Cosmic7373/ECE411/Documents/DesignReview.pdf

Team 13 Design Review
Done by Team 4
1) Include a short description of what your board does (anywhere but can be in the space above the TITLE, and include document number, revision number.
2) Approve your ERC warning
3) Your dimension layer (to draw the outline) is not straight (if you zoom in). Not sure if this would be the problem though.
4) I think your polygon should be overlapping with your dimension layer.
5) After you type DRC and load the oshpark 2 layer .dru file, click on the Masks tab and change the Limit to 0.4mm. This is because your GND vias have dimension of 0.35 mm so the Mask limit can be set to any value larger than that. This is to make your GND vias filled with solder mask.
6) Have your team name, project name, etc. on the tPlace layer. (type layer and select tPlace)
