Cosmic7373/ECE411/Documents/BOM.xlsx

Part | Value | MPN | Device | Package | Quantity Per Board | Description | DESC | MFR
SW2 | !RESET | RS-187R05A2-DS MT RT | SWITCH-MOMENTARY-2SMD | TACTILE_SWITCH_SMD | 1 | Various NO switches- pushbuttons, reed, etc | SWITCH TACTILE SPST-NO 0.05A 12V | C&K
C20 | .1u |  | C2,5-3 | C2.5-3 | 1 | CAPACITOR
C15 | .33u |  | C2,5-3 | C2.5-3 | 1 | CAPACITOR
C2, C3, C4, C9, C10, C11, C18 | 100n | CL21B104KBCNNNC | C-EUC0805K | C0805K | 7 | CAPACITOR, European symbol | CAP CER 0.1UF 50V X7R 0805 | Samsung
R2, R3, R6, R13, R14, R15, R16, R17, R18, R19, R20 | 10k | RC0805FR-0710KL | R-US_R0805 | R0805 | 11 | RESISTOR, American symbol | RES SMD 10K OHM 1% 1/8W 0805 | Yageo
X2 | 16 MHz | ECS-160-18-5PX-TR | CRYSTALSMD-HC49UP | HC49UP | 1 | Crystals (Generic) | CRYSTAL 16.000 MHZ 18PF SMD | ECS
R1, R8, R10, R11, R12 | 1K | RC0805FR-071KL | R-US_R0805 | R0805 | 5 | RESISTOR, American symbol | RES SMD 1K OHM 1% 1/8W 0805 | Yageo
C5 | 1u | CL21B105KOFNNNG | C-EUC0805K | C0805K | 1 | CAPACITOR, European symbol | CAP CER 1UF 16V X7R 0805 | Samsung
R7, R9, R21, R22 | 2.2k | RC0805FR-072K2L | R-US_R0805 | R0805 | 4 | RESISTOR, American symbol | RES SMD 2.2K OHM 1% 1/8W 0805 | Yageo
R4, R5 | 22 | RC0805FR-0722RL | R-US_R0805 | R0805 | 2 | RESISTOR, American symbol | RES SMD 22 OHM 1% 1/8W 0805 | Yageo
C16, C17 | 30p | CL21C180JBANNNC | C-EUC0805K | C0805K | 2 | CAPACITOR, European symbol | CAP CER 18PF 50V C0G/NP0 0805 | Samsung
J1 | 3x2 M | M20-9980345 | PINHD-2X3 | 2X03 | 1 | PIN HEADER | CONN HEADER VERT 6POS 2ROW 2.54MM | Harwin
C6, C7, C8, C19 | 4.7u | CL21A475KOFNNNE | C-EUC0805K | C0805K | 4 | CAPACITOR, European symbol | CAP CER 4.7UF 16V X5R 0805 | Samsung
C1 | 470p | CL21B471KBANNNC | C-EUC0805K | C0805K | 1 | CAPACITOR, European symbol | CAP CER 470PF 50V X7R 0805 | Samsung
J3 | 629105136821 | 629105136821 | 629105136821 | 629105136821 | 1 | WR-COM SMT Horizontal 5 Contacts Micro USB Type B,5 pins=>Code : Con_I-O_COM_MicroUSB_629105136821 | CONN RCPT USB2.0 MICRO B SMD R/A | Wurth
VOLTAGE_REGULATOR | 7805ABV |  | 7805H | TO39 | 1 | Positive VOLTAGE REGULATOR
U3 | ATMEGA32U4-AUR | ATMEGA32U4-AUR | ATMEGA32U4TQFP-44 | TQFP44 | 1 | Atmel MCU, 32KByte | IC MCU 8BIT 32KB FLASH 44TQFP | Microchip
SW1 | AYZ0202AGRLC | AYZ0202AGRLC | SWITCH-DPDTSMD | AYZ0202 | 1 | DPDT Version of the COM-00597 | SWITCH SLIDE DPDT 100MA 12V | C&K
D1, D4 | B340A | B340AE-13 | DIODE-SCHOTTKY_ | SMA-DIODE | 2 | Commonly MBRA140. | DIODE SCHOTTKY 40V 2A SMA | Diodes Inc
D2, D3, D5, D6, D7 | GREEN | 150080GS75000 | LEDCHIP-LED0805 | CHIP-LED0805 | 5 | LED | LED GREEN CLEAR 0805 SMD | WÃ¼rth Elektronik
U1 | MCP73831 | MCP73831T-2ACI/OT | MCP73831 | SOT23-5 | 1 | Miniature single cell, fully integrated Li-Ion, Li-polymer charge management controller | IC CONTROLLR LI-ION 4.2V SOT23-5 | Microchip
U2 | MIC5219 | MIC5219-3.3YM5-TR | V_REG_MIC5219SMD | SOT23-5 | 1 | V_REG MIC5219 | IC REG LINEAR 3.3V 500MA SOT23-5 | Microchip
J2 | S2B-PH-SM4-TB(LF)(SN) | S2B-PH-SM4-TB(LF)(SN) | M02-JST-2MM-SMT | JST-2-SMD | 1 | Header 2 | CONN HEADER SMD R/A 2POS 2MM | JST
U4, U5 |  | ZXMHC3F381N8TC | ZXMHC3F381N8DICT-ND |  | 2 | MOSFET 2N/2P-CH 30V 8-SOIC | H-Bridge | Diodes Inc
Q1,Q2 |  | 2N2222A PBFREE | 2N2222 | Through Hole | 2 | TRANS NPN 40V 0.8A TO-18 | NPN BJT | Central Semiconductor
