Cosmic7373/ECE411/Documents/Expenditures.xlsx

Bliss |  |  | Colton |  |  | Grace |  |  | Mike
Items ordered | Order Cost (Include Shipping, Tax, etc.) | Date | Items ordered | Order Cost (Include Shipping, Tax, etc.) | Date | Items ordered | Order Cost (Include Shipping, Tax, etc.) | Date | Items ordered | Order Cost (Include Shipping, Tax, etc.) | Date
Atmega Breakout Board x2 | $29.88 |  | Li-Ion Battery Pack | $24.99 | Oct. 25 |  |  |  | Chassis x1, Battery compartments x2 | $23.88 | Oct. 19
 |  |  |  |  |  |  |  |  | Atmegas x4 | $25.31 | Oct. 25
 |  |  |  |  |  |  |  |  | Li-Ion Battery x1 | $5.95 | Oct. 30
 |  |  |  |  |  |  |  |  | Board Components (See Component Invoice.xlsx) | $64.93 | Oct.31
 |  |  |  |  |  |  |  |  | Extra Long Headers (pack of 5) | $10.99 | Nov. 19
 |  |  |  |  |  |  |  |  | MtF Ribbon Cable x1 | $10.49 | Nov. 19
 |  |  |  |  |  |  |  |  | .33 uF caps, 8x2 headers, 4x1 headers (4 ea.) | $12.92 | Nov. 19
Total |  |  | Total |  |  | Total |  |  | Total
