Cosmic7373/ECE411/Board_Schematic/ece411-t13-fearbot.brd

## EAGLE design Board_Schematic/ece411-t13-fearbot.brd (2019-11-25)

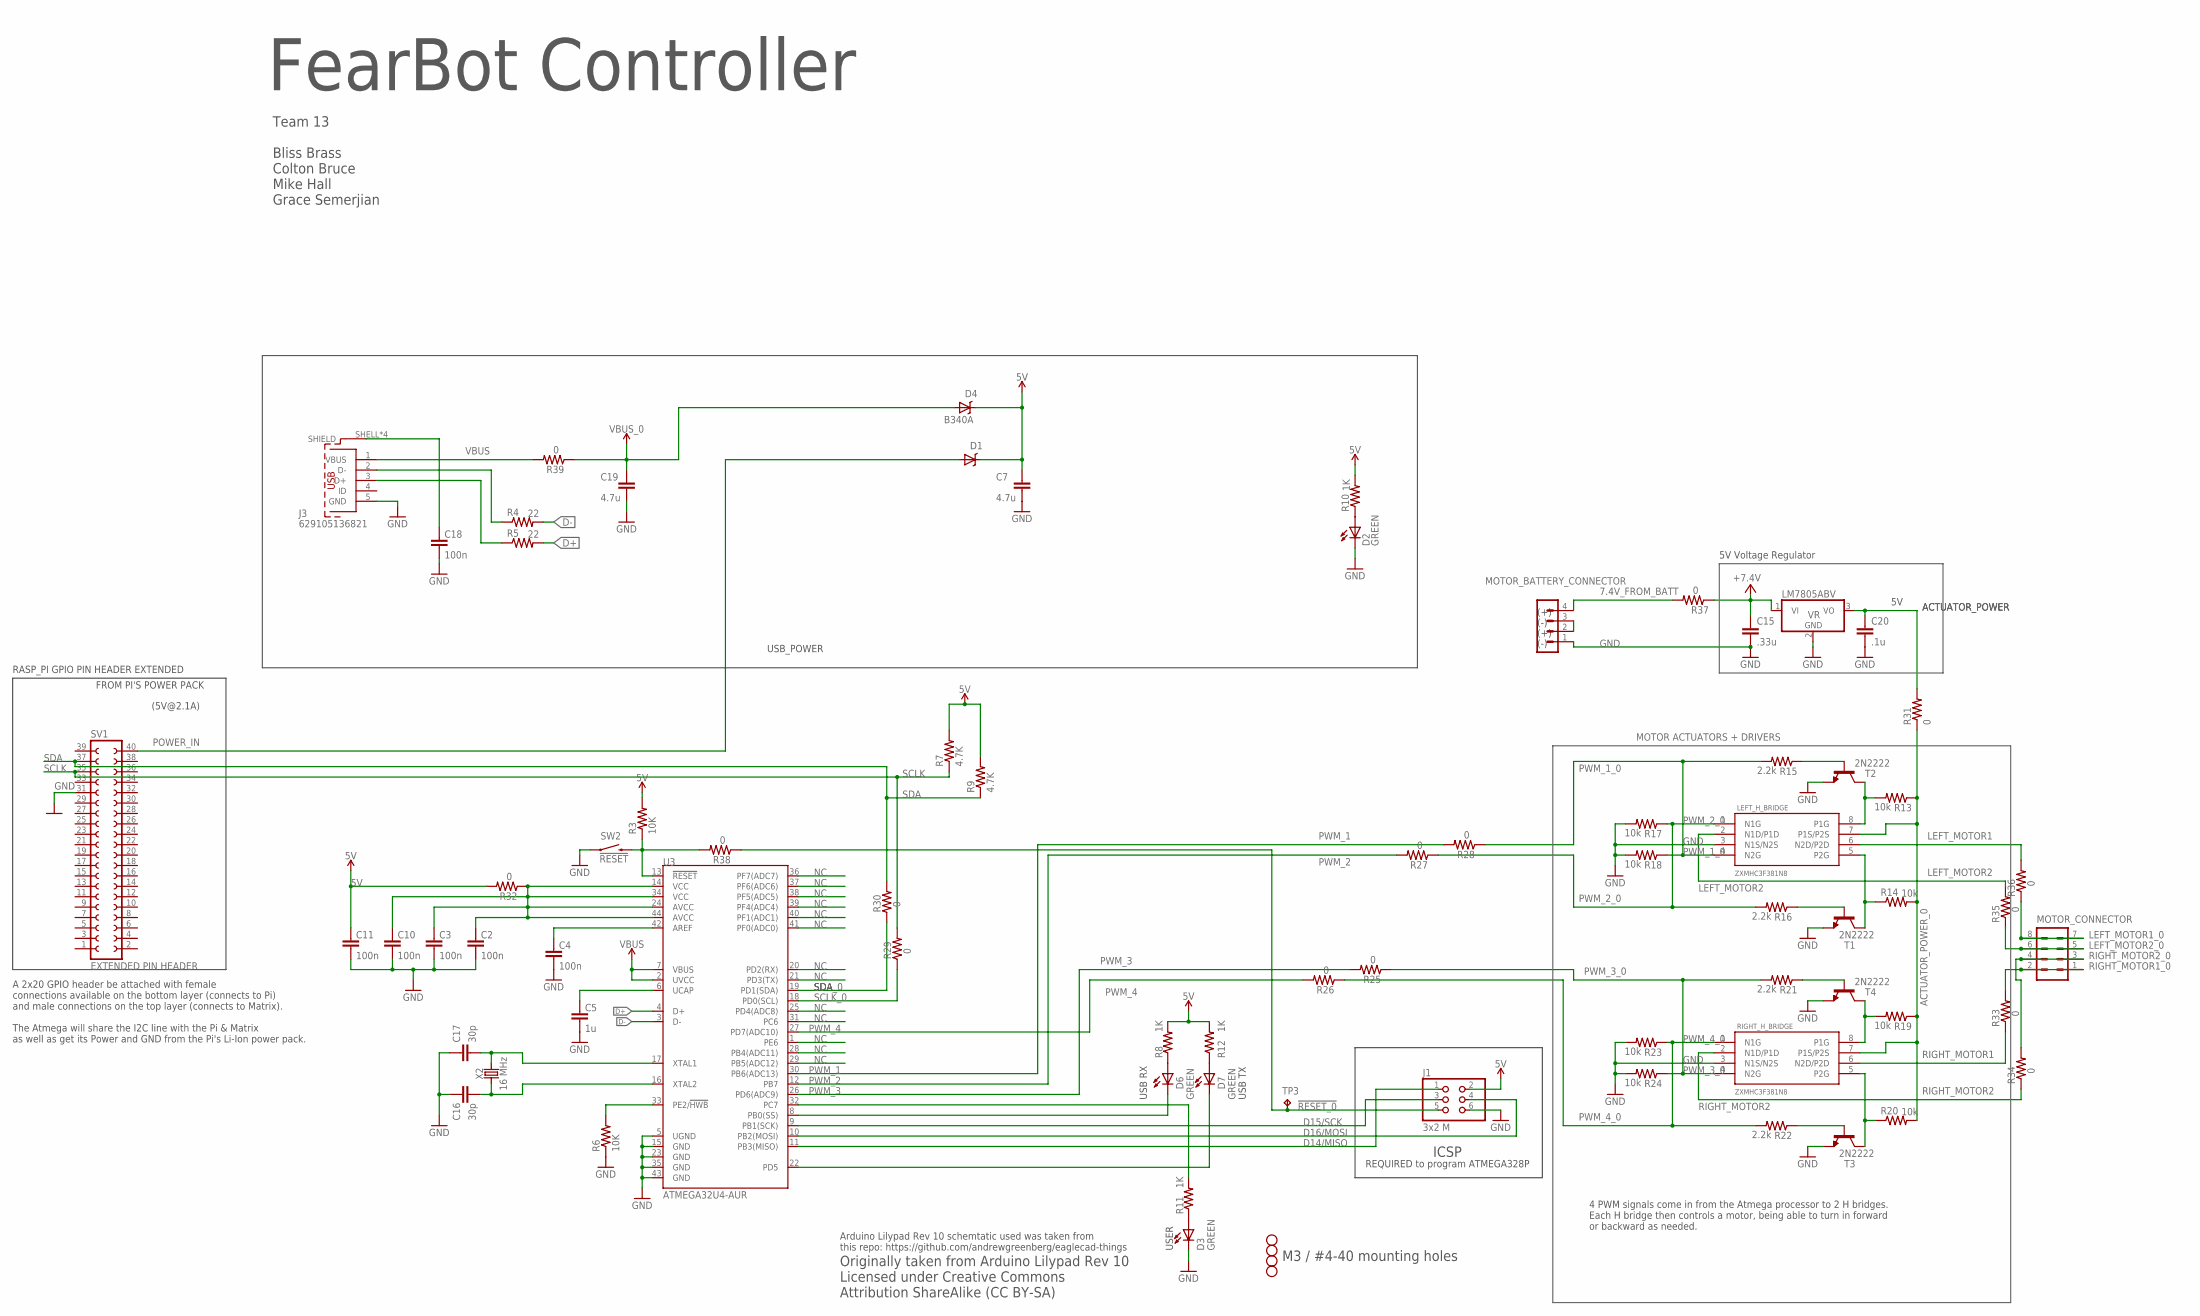
[picture p10: schematic ece411-t13-FearBot.sch]

Parts:
C2, C3, C4, C10, C11, C18: 100n; C0805K; MPN CL21B104KBCNNNC
C5: 1u; C0805K; MPN CL21B105KOFNNNG
C7, C19: 4.7u; C0805K; MPN CL21A475KOFNNNE
C15: .33u; C2.5-3
C16, C17: 30p; C0805K; MPN CL21C180JBANNNC
C20: .1u; C2.5-3
D1, D4: B340A; SMA-DIODE; MPN B340AE-13
D2, D3, D6, D7: GREEN; CHIP-LED0805; MPN 150080GS75000
H1, H2, H3, H4: STAND-OFF
J1: 3x2 M; 2X03; MPN M20-9980345
J3: 629105136821; MPN 629105136821
LEFT_H_BRIDGE: ZXMHC3F381N8; SOIC8
MOTOR_BATTERY_CONNECTOR: MOTOR_BATTERY_CONNECTOR; MA04-1
MOTOR_CONNECTOR: MOTOR_CONNECTOR; MA04-2
R3, R6: 10K; R0805; MPN RC0805FR-0710KL
R4, R5: 22; R0805; MPN RC0805FR-0722RL
R7, R9: 4.7K; R0805; MPN RC0805FR-0710KL
R8, R10, R11, R12: 1K; R0805; MPN RC0805FR-071KL
R13, R14, R17, R18, R19, R20, R23, R24: 10k; R0805; MPN RC0805FR-071KL
R15, R16, R21, R22: 2.2k; R0805; MPN RC0805FR-071KL
R25, R26, R27, R28, R29, R30, R31, R32, R33, R34, R35, R36, R37, R38, R39: 0; 0207/2V; MPN RC0805FR-0710KL
RIGHT_H_BRIDGE: ZXMHC3F381N8; SOIC8
SV1: EXTENDED PIN HEADER; FE20-2
SW2: !RESET; TACTILE_SWITCH_SMD; MPN RS-187R05A2-DS MT RT
T1, T2, T3, T4: 2N2222; TO92-EBC-OVAL
TP3: TPPAD1-13; P1-13
U3: ATMEGA32U4-AUR; TQFP44; MPN ATMEGA32U4-AUR
VR: LM7805ABV; TO220H
X2: 16 MHz; HC49UP; MPN ECS-160-18-5PX-TR

Connections:
5V: C7.1, C11.1, D1.C, D4.C, J1.2, R3.2, R7.2, R8.2, R9.2, R10.2, R12.2, R32.2
5V_0: C2.1, C3.1, C10.1, R32.1, U3.14 (VCC), U3.24 (AVCC), U3.34 (VCC), U3.44 (AVCC)
7.4V_FROM_BATT: MOTOR_BATTERY_CONNECTOR.4, R37.2
7.4_FROM_BATT_0: C15.1, R37.1, VR.1 (VI)
!RESET: R3.1, R38.2, SW2.3 (2), U3.13 (!RESET)
!RESET_0: J1.5, R38.1, TP3.TP
ACTUATOR_POWER: C20.1, R31.2, VR.3 (VO)
ACTUATOR_POWER_0: LEFT_H_BRIDGE.7 (P1S/P2S), R13.1, R14.2, R19.1, R20.2, R31.1, RIGHT_H_BRIDGE.7 (P1S/P2S)
AREF: C4.1, U3.42 (AREF)
D13#/USER_LED: R11.2, U3.32 (PC7)
D14/MISO: J1.1, U3.11 (PB3(MISO))
D15/SCK: J1.3, U3.9 (PB1(SCK))
D16/MOSI: J1.4, U3.10 (PB2(MOSI))
D17/RX-LED: D6.C, U3.8 (PB0(SS))
D+: R5.2, U3.4 (D+)
D-: R4.2, U3.3 (D-)
GND: C2.2, C3.2, C4.2, C5.2, C7.2, C10.2, C11.2, C15.2, C16.2, C17.2, C18.2, C19.2, C20.2, D2.C, D3.C, J1.6, J3.5 (GND), LEFT_H_BRIDGE.3 (N1S/N2S), MOTOR_BATTERY_CONNECTOR.1, R6.1, R17.2, R18.2, R23.2, R24.2, RIGHT_H_BRIDGE.3 (N1S/N2S), SV1.31, SW2.1, T1.E, T2.E, T3.E, T4.E, U3.5 (UGND), U3.15 (GND), U3.23 (GND), U3.35 (GND), U3.43 (GND), VR.2 (GND)
LEFT_MOTOR1: LEFT_H_BRIDGE.6 (N2D/P2D), R36.2
LEFT_MOTOR1_0: MOTOR_CONNECTOR.7, MOTOR_CONNECTOR.8, R36.1
LEFT_MOTOR2: LEFT_H_BRIDGE.2 (N1D/P1D), R35.2
LEFT_MOTOR2_0: MOTOR_CONNECTOR.5, MOTOR_CONNECTOR.6, R35.1
unnamed: MOTOR_BATTERY_CONNECTOR.2, MOTOR_BATTERY_CONNECTOR.3
unnamed: D2.A, R10.1
unnamed: LEFT_H_BRIDGE.5 (P2G), R14.1, T1.C
unnamed: LEFT_H_BRIDGE.8 (P1G), R13.2, T2.C
unnamed: R15.1, T2.B
unnamed: R16.1, T1.B
unnamed: D3.A, R11.1
unnamed: C18.1, J3.SHELL (SHIELD), J3.SHELL1 (SHIELD), J3.SHELL2 (SHIELD), J3.SHELL3 (SHIELD)
unnamed: D6.A, R8.1
unnamed: D7.A, R12.1
unnamed: R20.1, RIGHT_H_BRIDGE.5 (P2G), T3.C
unnamed: R19.2, RIGHT_H_BRIDGE.8 (P1G), T4.C
unnamed: J3.2 (D-), R4.1
unnamed: J3.3 (D+), R5.1
unnamed: R21.1, T4.B
unnamed: R22.1, T3.B
NC: U3.20 (PD2(RX)), U3.21 (PD3(TX))
PE2/!HWB: R6.2, U3.33 (PE2/!HWB)
POWER_IN: D1.A, SV1.40
PWM_1: R28.2, U3.30 (PB6(ADC13))
PWM_1_0: LEFT_H_BRIDGE.4 (N2G), R15.2, R18.1, R28.1
PWM_2: R27.2, U3.12 (PB7)
PWM_2_0: LEFT_H_BRIDGE.1 (N1G), R16.2, R17.1, R27.1
PWM_3: R25.2, U3.26 (PD6(ADC9))
PWM_3_0: R21.2, R24.1, R25.1, RIGHT_H_BRIDGE.4 (N2G)
PWM_4: R26.2, U3.27 (PD7(ADC10))
PWM_4_0: R22.2, R23.1, R26.1, RIGHT_H_BRIDGE.1 (N1G)
RIGHT_MOTOR1: R33.1, RIGHT_H_BRIDGE.6 (N2D/P2D)
RIGHT_MOTOR1_0: MOTOR_CONNECTOR.1, MOTOR_CONNECTOR.2, R33.2
RIGHT_MOTOR2: R34.1, RIGHT_H_BRIDGE.2 (N1D/P1D)
RIGHT_MOTOR2_0: MOTOR_CONNECTOR.3, MOTOR_CONNECTOR.4, R34.2
SCLK: R7.1, R29.2, SV1.35
SCLK_0: R29.1, U3.18 (PD0(SCL))
SDA: R9.1, R30.2, SV1.37
SDA_0: R30.1, U3.19 (PD1(SDA))
TX_LED: D7.C, U3.22 (PD5)
UCAP: C5.1, U3.6 (UCAP)
VBUS: J3.1 (VBUS), R39.2, U3.2 (UVCC), U3.7 (VBUS)
VBUS_0: C19.1, D4.A, R39.1
XTAL1: C17.1, U3.17 (XTAL1), X2.2
XTAL2: C16.1, U3.16 (XTAL2), X2.1

Notes on the sheet:
Originally taken from Arduino Lilypad Rev 10 Licensed under Creative Commons Attribution ShareAlike (CC BY-SA)
M3 / #4-40 mounting holes
ICSP
REQUIRED to program ATMEGA328P
USB RX
USB TX
USER
MOTOR ACTUATORS + DRIVERS
USB_POWER
(5V@2.1A)
RASP_PI GPIO PIN HEADER EXTENDED
A 2x20 GPIO header be attached with female connections available on the bottom layer (connects to Pi) and male connections on the top layer (connects to Matrix). The Atmega will share the I2C line with the Pi & Matrix as well as get its Power and GND from the Pi's Li-Ion power pack.
FROM PI'S POWER PACK
Arduino Lilypad Rev 10 schemtatic used was taken from this repo: https://github.com/andrewgreenberg/eaglecad-things
(+)
(-)
5V Voltage Regulator
4 PWM signals come in from the Atmega processor to 2 H bridges. Each H bridge then controls a motor, being able to turn in forward or backward as needed.
FearBot Controller
Team 13 Bliss Brass Colton Bruce Mike Hall Grace Semerjian

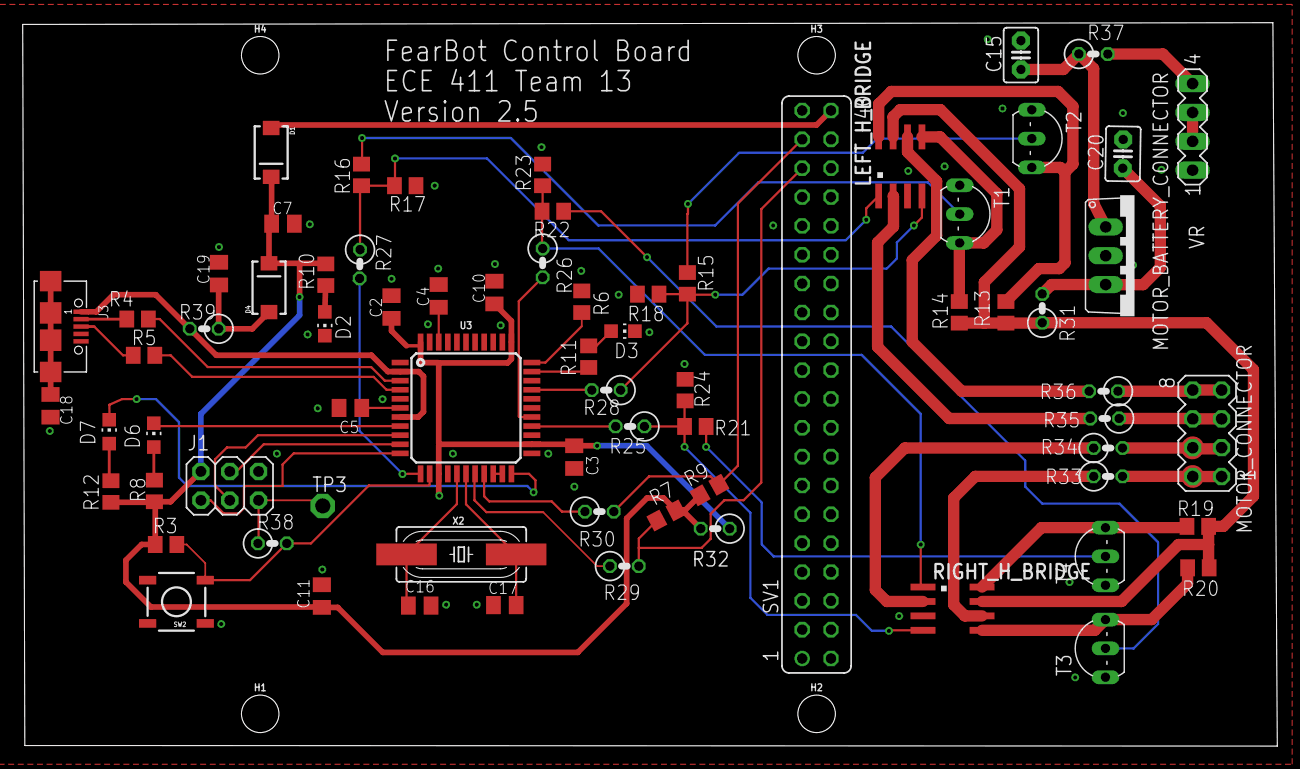
[picture p11: board ece411-t13-fearbot.brd from above]

Board: 2 copper layers, 110.5 x 63.7 mm, 76 parts (0 on the bottom side), 62 nets.
