Cosmic7373/ECE411/(commit log)

2019-10-22 Commit test of expenditures
    [Expenditures.xlsx]
2019-10-29 I started the schematic, it's got some Rasp Pi components and the Matrix Voice's FPGA on there
    [startinglayout.sch]
2019-10-30 I think that I'm almost done with the schematic
    It needs the Li-Ion for the Matrix/Rasp/ATMega
    [startinglayout.sch]
2019-10-30 Added in power supply, reduced PWM channels, added in UART (from ATmega), and converted H Bridges
    [startinglayout.sch]
2019-10-31 Updated Expenditures Spreadsheet
    [Expenditures.xlsx]
2019-10-31 Pic of the breadboard prototype
2019-10-31 Video of chassis moving
2019-10-31 Expenditures Update
    [Expenditures.xlsx]
2019-10-31 Adding invoice for board components, and updating expenditures
    [Component Invoice.xlsx, Expenditures.xlsx]
2019-11-02 Updated Expenditures and added Digi-Key order invoice
    [Expenditures.xlsx, PCB Component Invoice.xlsx]
2019-11-07 Added in the H Bridge ICs and removed what was before
    [startinglayout.sch]
2019-11-07 This was the functional schematic that I used to build the preliminary pcb
    [forpcblayout.sch]
2019-11-07 The preliminary pcb itself
    [forpcblayout.brd]
2019-11-13 Uploading initial draft of BOM
    [BOM.xlsx]
2019-11-14 Inluded H-bridge ICs, more connectors, and replaced UART with I2C
    [forpcblayout.sch]
2019-11-14 PCB layout of schematic, and now has flooded gnds on both layers
    [forpcblayout.brd]
2019-11-14 Adding BOM
    [BOM.xlsx]
2019-11-16 Added in connector for Pi to ATMega as well as battery for the schematic
    Mounting holes line up (more or less) with the Pi now
    We still need the right H Bridge Driver ICs, check GNDing, adding in vias for ea. GND connection, and check up on decoupling caps for power sources
    [forpcblayout.brd, forpcblayout.sch]
2019-11-16 Added Expenditure
    [Expenditures.xlsx]
2019-11-16 Added breakouts to Bliss's expenditures
    [Expenditures.xlsx]
2019-11-16 Added H-Bridge IC and topology to schematic
2019-11-16 Added H-Bridge to Board
    [forpcblayout.sch]
2019-11-17 Board tweaks- spacing and right angle approaches to pads
    [forpcblayout.brd]
2019-11-18 Fixed routing mistakes, extended board edge to clear matrix
    [forpcblayout.brd, forpcblayout.sch]
2019-11-19 Added in 0ohm resistors and added in vias (for stitching)
    GND Plane is still a question mark, vias don't seem to be part of flooded planes. Also DRC claims GND pins aren't connected to GND plane
    [forpcblayout.brd, forpcblayout.sch]
2019-11-20 Updated Expenditures
    [Expenditures.xlsx]
2019-11-20 Changed 0ohm resistors to through hole
    [forpcblayout.brd, forpcblayout.sch]
2019-11-21 Changed just about everything
    Jk, changed wire widths, stitched properly, passed ERC as well as DRC
    [forpcblayout.brd, forpcblayout.sch]
2019-11-21 Made board slimmer, changed mask tab's limit, and included diff. DRU (Laen)
    [forpcblayout.brd, forpcblayout.sch]
2019-11-21 Traces orthogonal to pads, schematic title, frame value, motor pin de-fucking.
    [forpcblayout.brd, forpcblayout.sch]
2019-11-21 De-de-fucked motor header connections
    [forpcblayout.brd, forpcblayout.sch]
2019-11-21 Neutralized Silkscreen Menace
    [forpcblayout.brd]
2019-11-21 Uploading final board/schematic
    [forpcblayout.sch]
2019-11-21 Rename board and add design review
    [ece411-t13-FearBot.brd, ece411-t13-FearBot.sch]
2019-11-21 Changing voltage regulator to vertical footprint to correct extra hole.
    [forpcblayout.brd]
2019-11-21 Adding Final Board Version Submitted to OSHPark
    Changed to vertical footprint for v-regulator to fix hole issue
    [ece411-t13-fearbot.brd, ece411-t13-fearbot.sch]
2019-12-09 Uploading Arduino Code
    Control Code for the Atmega32u4 as well as test code for the ItsyBitsy breakout board and a i2c detect function for the Arduino side
2019-12-12 Organized Documents
    [BOM.xlsx, Component Invoice.xlsx, Expenditures.xlsx, PCB Component Invoice.xlsx, ece411-t13-FearBot.sch, ece411-t13-fearbot.brd, forpcblayout.brd, forpcblayout.sch]
